MissouriMRDT/Tiva_Breakout_Hardware/TIVA Breakout/Documentation/CDR Notes.txt

Change CRRT to whatever Anthony has
	12V_ISENSE
Change ON to EN
Flag directions
Put tiny wires on flags
Change from SL connectors
Add LEDs for all digital signals
	Blue LED for on
	330 Ohm resistors
	Use 1 other pin for a red failure LED
	Blue on all digital pins for activation
Put connectors on the bottom
Add grounds to each connector
