MissouriMRDT/Tiva_Breakout_Hardware/TIVA Breakout/Tiva_Breakout_Hardware/Tiva_Breakout_Hardware.kicad_pcb

## KiCad design TIVA Breakout/Tiva_Breakout_Hardware/Tiva_Breakout_Hardware.kicad_pcb (2020-02-15)

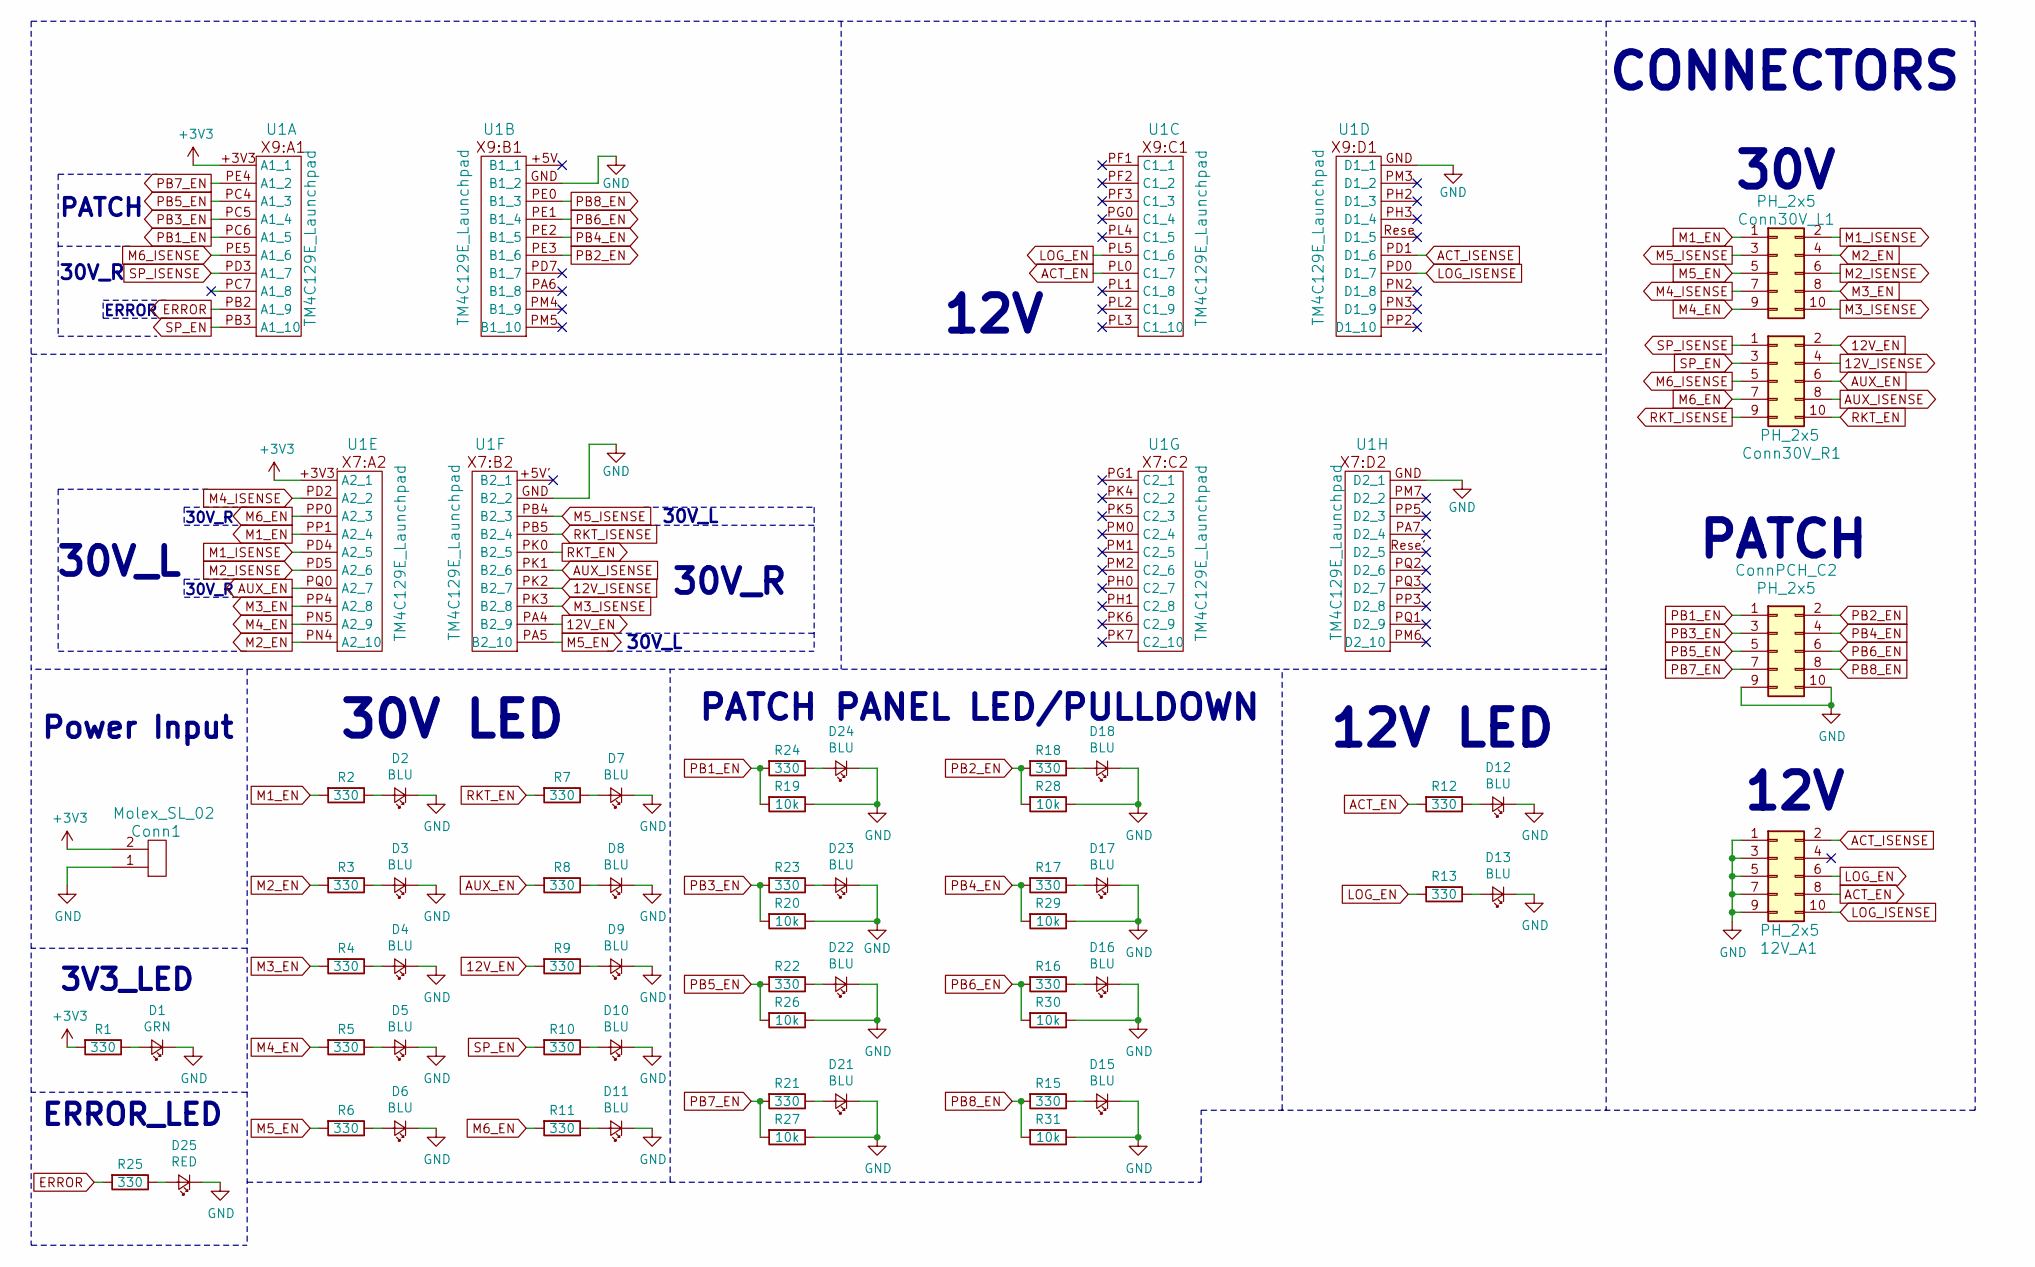
[picture p1: schematic Tiva_Breakout_Hardware.sch]

Parts:
12V_A1: PH_2x5; JTAG_ARM_Connector_10_Pin
Conn1: Molex_SL_02; MOLEX_SL_02_Horizontal
Conn30V_L1, Conn30V_R1: PH_2x5; JTAG_ARM_Connector_10_Pin
ConnPCH_C2: PH_2x5; JTAG_ARM_Connector_10_Pin
D1: GRN; LED_0603_1608Metric_Pad1.05x0.95mm_HandSolder
D2, D3, D4, D5, D6, D7, D8, D9, D10, D11, D12, D13, D15, D16, D17, D18, D21, D22, D23, D24: BLU; LED_0603_1608Metric_Pad1.05x0.95mm_HandSolder
D25: RED; LED_0603_1608Metric_Pad1.05x0.95mm_HandSolder
R1, R2, R3, R4, R5, R6, R7, R8, R9, R10, R11, R12, R13, R15, R16, R17, R18, R21, R22, R23, R24, R25: 330; R_0603_1608Metric_Pad1.05x0.95mm_HandSolder
R19, R20, R26, R27, R28, R29, R30, R31: 10k; R_0603_1608Metric_Pad1.05x0.95mm_HandSolder
U1: TM4C129E_Launchpad; Tiva_Breakout

Connections:
12V_EN: Conn30V_R1.2, R9.2, U1.PA4 (B2_9)
12V_ISENSE: Conn30V_R1.4, U1.PK2 (B2_7)
+3V3: Conn1.2, R1.2, U1.+3V3 (A1_1), U1.+3V3' (A2_1)
ACT_EN: 12V_A1.8, R12.2, U1.PL0 (C1_7)
ACT_ISENSE: 12V_A1.2, U1.PD1 (D1_6)
AUX_EN: Conn30V_R1.6, R8.2, U1.PQ0 (A2_7)
AUX_ISENSE: Conn30V_R1.8, U1.PK1 (B2_6)
ERROR: R25.2, U1.PB2 (A1_9)
GND: 12V_A1.1, 12V_A1.3, 12V_A1.5, 12V_A1.7, 12V_A1.9, Conn1.1, ConnPCH_C2.9, ConnPCH_C2.10, D1.1 (K), D2.1 (K), D3.1 (K), D4.1 (K), D5.1 (K), D6.1 (K), D7.1 (K), D8.1 (K), D9.1 (K), D10.1 (K), D11.1 (K), D12.1 (K), D13.1 (K), D15.1 (K), D16.1 (K), D17.1 (K), D18.1 (K), D21.1 (K), D22.1 (K), D23.1 (K), D24.1 (K), D25.1 (K), R19.1, R20.1, R26.1, R27.1, R28.1, R29.1, R30.1, R31.1, U1.GND (B1_2)
LOG_EN: 12V_A1.6, R13.2, U1.PL5 (C1_6)
LOG_ISENSE: 12V_A1.10, U1.PD0 (D1_7)
M1_EN: Conn30V_L1.1, R2.2, U1.PP1 (A2_4)
M1_ISENSE: Conn30V_L1.2, U1.PD4 (A2_5)
M2_EN: Conn30V_L1.4, R3.2, U1.PN4 (A2_10)
M2_ISENSE: Conn30V_L1.6, U1.PD5 (A2_6)
M3_EN: Conn30V_L1.8, R4.2, U1.PP4 (A2_8)
M3_ISENSE: Conn30V_L1.10, U1.PK3 (B2_8)
M4_EN: Conn30V_L1.9, R5.2, U1.PN5 (A2_9)
M4_ISENSE: Conn30V_L1.7, U1.PD2 (A2_2)
M5_EN: Conn30V_L1.5, R6.2, U1.PA5 (B2_10)
M5_ISENSE: Conn30V_L1.3, U1.PB4 (B2_3)
M6_EN: Conn30V_R1.7, R11.2, U1.PP0 (A2_3)
M6_ISENSE: Conn30V_R1.5, U1.PE5 (A1_6)
unnamed: D1.2 (A), R1.1
unnamed: D2.2 (A), R2.1
unnamed: D3.2 (A), R3.1
unnamed: D4.2 (A), R4.1
unnamed: D5.2 (A), R5.1
unnamed: D6.2 (A), R6.1
unnamed: D7.2 (A), R7.1
unnamed: D8.2 (A), R8.1
unnamed: D9.2 (A), R9.1
unnamed: D10.2 (A), R10.1
unnamed: D11.2 (A), R11.1
unnamed: D12.2 (A), R12.1
unnamed: D13.2 (A), R13.1
unnamed: D15.2 (A), R15.1
unnamed: D16.2 (A), R16.1
unnamed: D17.2 (A), R17.1
unnamed: D18.2 (A), R18.1
unnamed: D21.2 (A), R21.1
unnamed: D22.2 (A), R22.1
unnamed: D23.2 (A), R23.1
unnamed: D24.2 (A), R24.1
unnamed: D25.2 (A), R25.1
PB1_EN: ConnPCH_C2.1, R19.2, R24.2, U1.PC6 (A1_5)
PB2_EN: ConnPCH_C2.2, R18.2, R28.2, U1.PE3 (B1_6)
PB3_EN: ConnPCH_C2.3, R20.2, R23.2, U1.PC5 (A1_4)
PB4_EN: ConnPCH_C2.4, R17.2, R29.2, U1.PE2 (B1_5)
PB5_EN: ConnPCH_C2.5, R22.2, R26.2, U1.PC4 (A1_3)
PB6_EN: ConnPCH_C2.6, R16.2, R30.2, U1.PE1 (B1_4)
PB7_EN: ConnPCH_C2.7, R21.2, R27.2, U1.PE4 (A1_2)
PB8_EN: ConnPCH_C2.8, R15.2, R31.2, U1.PE0 (B1_3)
RKT_EN: Conn30V_R1.10, R7.2, U1.PK0 (B2_5)
RKT_ISENSE: Conn30V_R1.9, U1.PB5 (B2_4)
SP_EN: Conn30V_R1.3, R10.2, U1.PB3 (A1_10)
SP_ISENSE: Conn30V_R1.1, U1.PD3 (A1_7)

Notes on the sheet:
CONNECTORS
30V_R
30V_L
12V
30V LED
12V LED
Power Input
PATCH PANEL LED/PULLDOWN
3V3_LED
ERROR_LED
PATCH
30V
ERROR

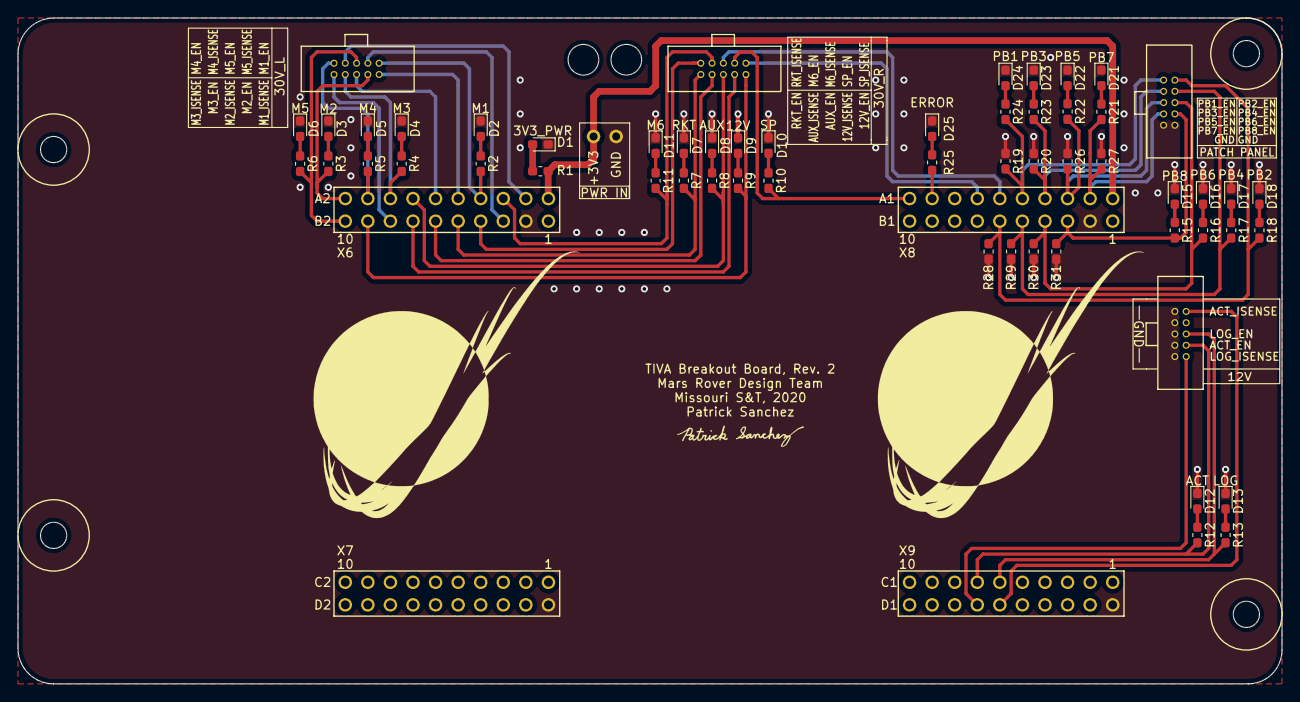
[picture p2: board Tiva_Breakout_Hardware.kicad_pcb from above]

Board: 2 copper layers, 142.2 x 74.9 mm, 58 parts (1 on the bottom side), 57 nets.
