MissouriMRDT/Tiva_Breakout_Hardware/(commit log)

2019-10-06 Inital commit
    [2019_Tive_Breakout.kicad_pcb, 2019_Tive_Breakout.sch]
2019-10-09 renamed files to proper tiva spelling
    [2019_Tiva_Breakout.kicad_pcb, 2019_Tiva_Breakout.sch]
2019-10-09 removed old files
    [2019_Tive_Breakout.kicad_pcb, 2019_Tive_Breakout.sch]
2019-10-09 Updated silkscreen with required information
    [2019_Tiva_Breakout.kicad_pcb]
2019-10-09 Added start of BOM file
    [2019_Tiva_Breakout.csv]
2019-10-09 renamed board folder to match standards
    [Tiva_Breakout_Hardware.csv, Tiva_Breakout_Hardware.kicad_pcb, Tiva_Breakout_Hardware.sch]
2019-10-10 Adjustments to labels for readability
    [Tiva_Breakout_Hardware.kicad_pcb]
2019-11-03 Removed unnecessary connectors in schematic to reflect other boards
    [Tiva_Breakout_Hardware.sch]
2019-11-14 rearranged pcb to account for physical layout
    [Tiva_Breakout_Hardware.kicad_pcb, Tiva_Breakout_Hardware.sch]
2019-11-15 In process of changing layout for smaller board
    [Tiva_Breakout_Hardware-Box.sch, Tiva_Breakout_Hardware.kicad_pcb, Tiva_Breakout_Hardware.sch]
2019-11-16 In process of rearranging for new layout
    [Tiva_Breakout_Hardware.kicad_pcb]
2019-11-21 New layout, as board is on left of others now. Changed pin assignments.
    [Tiva_Breakout_Hardware.kicad_pcb, Tiva_Breakout_Hardware.sch]
2019-11-22 Corrected schematic to match 30V board
    [Tiva_Breakout_Hardware.kicad_pcb, Tiva_Breakout_Hardware.sch]
2019-11-23 Ready for CDR
    [Tiva_Breakout_Hardware-B_Cu.gbr, Tiva_Breakout_Hardware-B_Mask.gbr, Tiva_Breakout_Hardware-B_Paste.gbr, Tiva_Breakout_Hardware-B_SilkS.gbr, Tiva_Breakout_Hardware-Edge_Cuts.gbr, Tiva_Breakout_Hardware-F_Cu.gbr, Tiva_Breakout_Hardware-F_Mask.gbr, Tiva_Breakout_Hardware-F_Paste.gbr]
2019-11-23 CDR Ready 2
    [Tiva_Breakout_Hardware-Box.sch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]
2019-12-08 Finished 30V LEDs and connectors
    [Tiva_Breakout_Hardware.kicad_pcb, Tiva_Breakout_Hardware.sch]
2019-12-09 Rerouted 30V for readability; routed 12V and LEDs
    [Tiva_Breakout_Hardware.kicad_pcb, Tiva_Breakout_Hardware.sch]
2019-12-09 Finished all wiring and LEDs, need resizing and silkscreen
    [Tiva_Breakout_Hardware.kicad_pcb, Tiva_Breakout_Hardware.sch]
2019-12-12 Finished layout, minus some silk screen stuff
    [Tiva_Breakout_Hardware.kicad_pcb, Tiva_Breakout_Hardware.sch]
2019-12-13 Added pulldown resistors & LED colors
    [Tiva_Breakout_Hardware.kicad_pcb, Tiva_Breakout_Hardware.sch]
2019-12-13 Added pullup resistors and pin labels
    [Tiva_Breakout_Hardware.kicad_pcb, Tiva_Breakout_Hardware.sch]
2019-12-14 Ready for PRR
    [Tiva_Breakout_BOM_Rev1.csv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]
2019-12-14 fixed some silkscreen labels
    [Tiva_Breakout_Hardware.kicad_pcb]
2019-12-14 completely finished PRR and BOM
    [Tiva_Breakout_BOM_Rev1.csv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]
2019-12-19 Fixed gerbs (no drill files here either)
    [Tiva_Breakout_Hardware-B_Cu.gbr, Tiva_Breakout_Hardware-B_Mask.gbr, Tiva_Breakout_Hardware-B_Paste.gbr, Tiva_Breakout_Hardware-B_SilkS.gbr, Tiva_Breakout_Hardware-Edge_Cuts.gbr, Tiva_Breakout_Hardware-F_Cu.gbr, Tiva_Breakout_Hardware-F_Mask.gbr, Tiva_Breakout_Hardware-F_Paste.gbr]
2020-01-13 Ready for Board Review, questions about PB#
    [Tiva_Breakout_Hardware-B_Cu-Box.gbr, Tiva_Breakout_Hardware-B_Mask-Box.gbr, Tiva_Breakout_Hardware-B_Paste-Box.gbr, Tiva_Breakout_Hardware-B_SilkS-Box.gbr, Tiva_Breakout_Hardware-Edge_Cuts-Box.gbr, Tiva_Breakout_Hardware-F_Cu-Box.gbr, Tiva_Breakout_Hardware-F_Mask-Box.gbr, Tiva_Breakout_Hardware-F_Paste-Box.gbr]
2020-02-15 Ready for Rev 2 Review
    [Tiva_Breakout_BOM_Rev1.csv, Tiva_Breakout_Hardware.kicad_pcb, Tiva_Breakout_Hardware.sch]
2020-02-15 Github nuked the last one, so lets try again
    [Tiva_Breakout_BOM_Rev2.csv]
2020-02-15 Github please stop corrupting my files
    [Tiva_Breakout_Hardware-B_Cu.gbr, Tiva_Breakout_Hardware-B_Mask.gbr, Tiva_Breakout_Hardware-B_Paste.gbr, Tiva_Breakout_Hardware-B_SilkS.gbr, Tiva_Breakout_Hardware-Edge_Cuts.gbr, Tiva_Breakout_Hardware-F_Cu.gbr, Tiva_Breakout_Hardware-F_Mask.gbr, Tiva_Breakout_Hardware-F_Paste.gbr]
2020-02-15 Slight schematic update
    [Tiva_Breakout_Hardware.sch]
2020-02-17 updated gerbs
    [Tiva_Breakout_Hardware-B_Cu-Box.gbr, Tiva_Breakout_Hardware-B_Cu.gbr, Tiva_Breakout_Hardware-B_Mask-Box.gbr, Tiva_Breakout_Hardware-B_Mask.gbr, Tiva_Breakout_Hardware-B_Paste-Box.gbr, Tiva_Breakout_Hardware-B_Paste.gbr, Tiva_Breakout_Hardware-B_SilkS-Box.gbr, Tiva_Breakout_Hardware-B_SilkS.gbr]
